pfeifferandreas1985-create/IMU_Sensor_Server/i2c_scanner/i2c_scanner.ino

#include <Wire.h>

void setup() {
  Wire.begin(22, 21); // SDA=22, SCL=21
  Serial.begin(115200);
  while (!Serial);             // Wait for serial monitor
  Serial.println("\nI2C Scanner Start (SDA:21, SCL:22)");
}

void loop() {
  byte error, address;
  int nDevices;

  Serial.println("Scanning...");

  nDevices = 0;
  for(address = 1; address < 127; address++ ) {
    Wire.beginTransmission(address);
    error = Wire.endTransmission();

    if (error == 0) {
      Serial.print("I2C device found at address 0x");
      if (address < 16) 
        Serial.print("0");
      Serial.print(address, HEX);
      Serial.println("  !");

      nDevices++;
    }
    else if (error == 4) {
      Serial.print("Unknown error at address 0x");
      if (address < 16) 
        Serial.print("0");
      Serial.println(address, HEX);
    }    
  }
  if (nDevices == 0)
    Serial.println("No I2C devices found\n");
  else
    Serial.println("done\n");

  delay(5000);           // wait 5 seconds for next scan
}
