pfeifferandreas1985-create/IMU_Sensor_Server/firmware_debug/DeepDiagnostic/calibration_values.h

#ifndef CALIBRATION_VALUES_H
#define CALIBRATION_VALUES_H

// RESET TO ZERO FOR DEBUGGING
const float GYRO_BIAS[] = { 0.0f, 0.0f, 0.0f };
const float MAG_OFFSET[] = { 0.0f, 0.0f, 0.0f };
const float MAG_SCALE[]  = { 1.0f, 1.0f, 1.0f };

#endif
