pfeifferandreas1985-create/IMU_Sensor_Server/(commit log)

2026-02-19 Backup 2026-02-19_23-18-04 - Initial commit with Brownout/I2C stability fixes
    [DeepDiagnostic.ino, Main_erweiterterWatchdog.ino, Variante_A_ohneBMP280.ino, Variante_B_ohneAHT20.ino, Variante_C_ohneQMC5883P.ino, Variante_D_ohneMPU6050.ino, calibration_app.py, calibration_values.h]
2026-02-19 Update 2026-02-20_00-47-37 - Bugfixes: Madgwick begin(250Hz), Kalibrierung aktiv, Beta=1.0, Brownout-Schutz, AHT20-Timing, I2C-Recovery, Temp/Hoehe in Viewer
    [calibration_values.h, firmware_complete.ino, imu_viewer.py]
